IowaScaledEngineering/mss-atlasadapter/README.md

# mss-atlasadapter
Modular Signal System to Altas Signal System Adapter
