IowaScaledEngineering/mss-atlasadapter/pg/mss-atlasadapter-v1.1-b040309/mss-atlasadapter.pdf

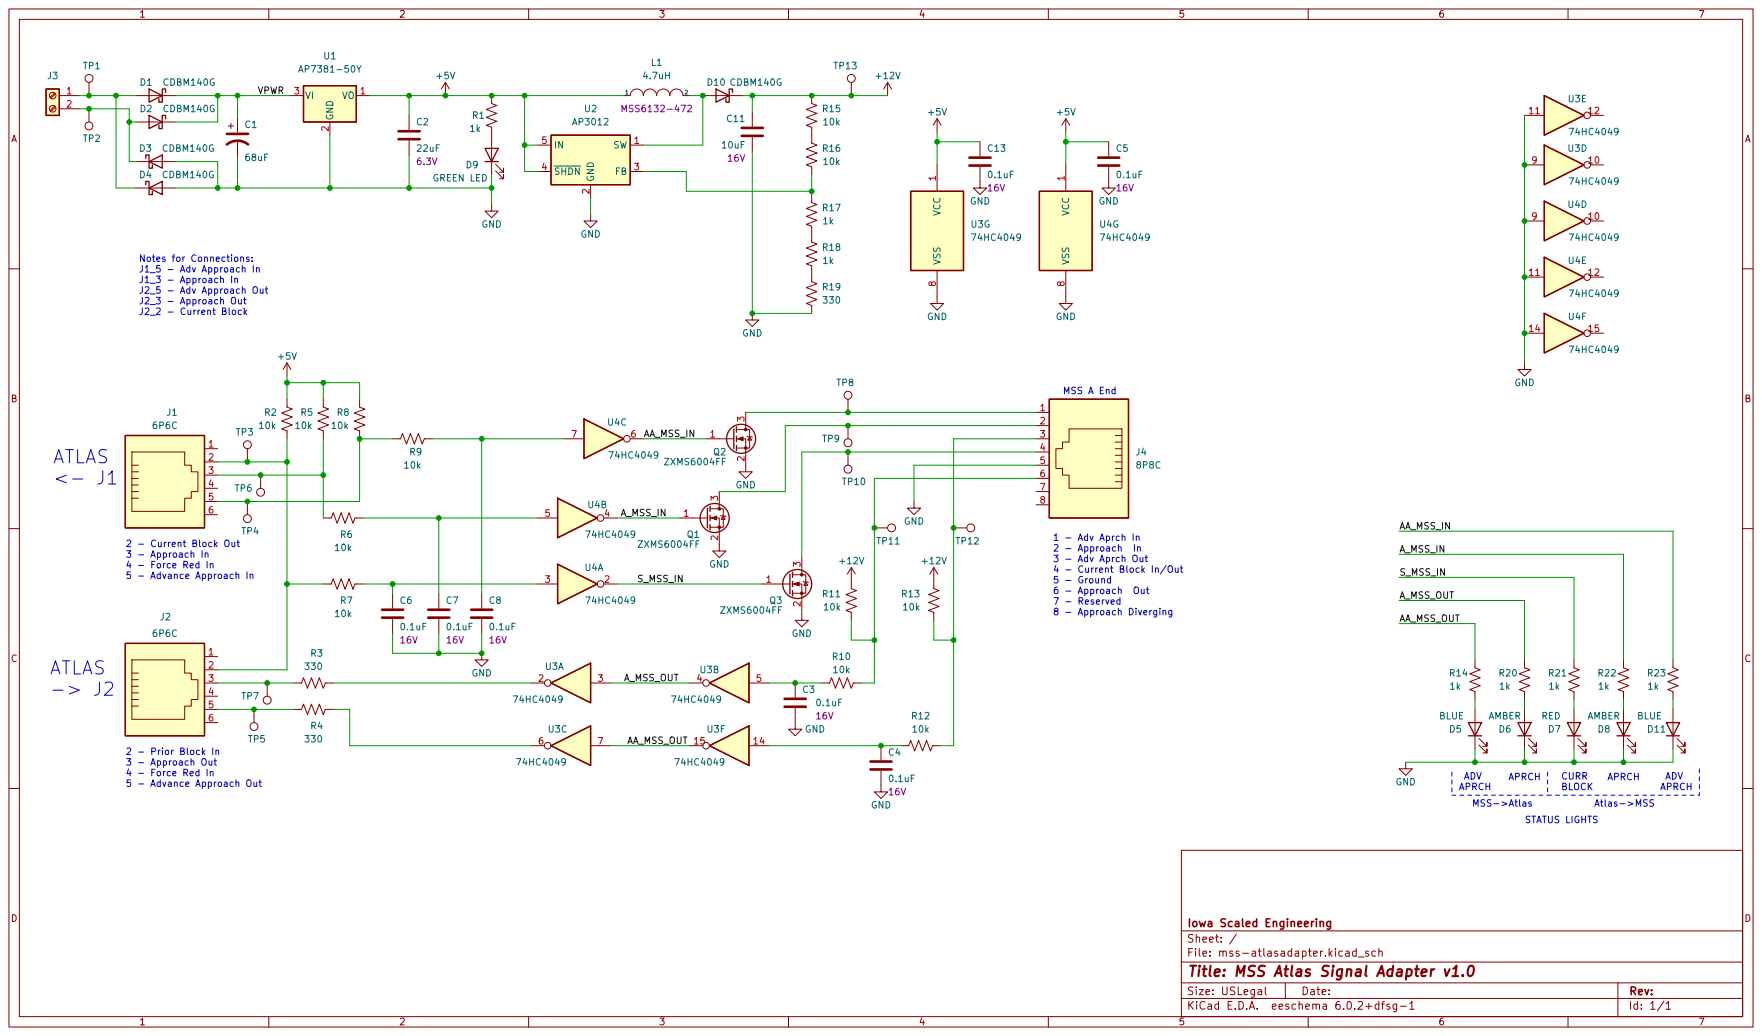
[picture p1: page 1]

Notes for Connections: J1_5 - Adv Approach In

J2_3 - Approach Out J2_2 - Current Block ATLAS

1 - Adv Aprch In
2 - Approach In
3 - Adv Aprch Out 4 - Current Block In/Out 5 - Ground

2 - Current Block Out 3 - Approach In

2 - Prior Block In
3 - Approach Out 4 - Force Red In

D Date: KiCad E.D.A. eeschema 6.0.2+dfsg-1
File: mss-atlasadapter.kicad_sch Sheet: /
Id: 1/1 Title: MSS Atlas Signal Adapter v1.0
