IowaScaledEngineering/mss-atlasadapter/(commit log)

2024-05-22 Start of Modular Signal System to Atlas Signal System adapter
    [mss-atlasadapter.kicad_pcb, mss-atlasadapter.kicad_sch]
2024-05-23 Initial cut of what I think is a working circuit
    [mss-atlasadapter.kicad_sch]
2024-05-27 First cut at board layout for the adapter
    [mss-atlasadapter.kicad_pcb, mss-atlasadapter.kicad_sch]
2024-05-27 Update 3d models
    [mss-atlasadapter.kicad_pcb]
2024-05-27 Fix stray hole that didn't get moved
    [mss-atlasadapter.kicad_pcb]
2024-05-27 Add test points
    [mss-atlasadapter.kicad_pcb, mss-atlasadapter.kicad_sch]
2024-05-28 Updates from Michael's review
    [mss-atlasadapter.kicad_pcb]
2024-05-29 Move under subdir so tapeout works
    [mss-atlasadapter.kicad_pcb, mss-atlasadapter.kicad_sch]
2024-05-29 PG 1.0
    [mss-atlasadapter-NPTH.drl, mss-atlasadapter.drl, mss-atlasadapter.gbl, mss-atlasadapter.gbo, mss-atlasadapter.gbp, mss-atlasadapter.gbr, mss-atlasadapter.gbs, mss-atlasadapter.gm1]
2024-06-07 Transposed the MSS A and AA lines coming out of the MSS module and into Atlas
    [mss-atlasadapter.kicad_pcb, mss-atlasadapter.kicad_sch]
2024-06-09 Add 12V test point
    [mss-atlasadapter.kicad_sch]
2024-07-01 Fixed DRC
    [mss-atlasadapter.kicad_pcb]
2024-07-09 Sent to fab July 2024
    [mss-atlasadapter-NPTH.drl, mss-atlasadapter.drl, mss-atlasadapter.gbl, mss-atlasadapter.gbo, mss-atlasadapter.gbp, mss-atlasadapter.gbr, mss-atlasadapter.gbs, mss-atlasadapter.gm1]
