IowaScaledEngineering/mss-atlasadapter/(notices)

Notices in the files:
kicad/mss-atlasadapter/mss-atlasadapter.kicad_pcb:
www.iascaled.com ©2024
